Lautstark/voice-button/compact72/exploded.png

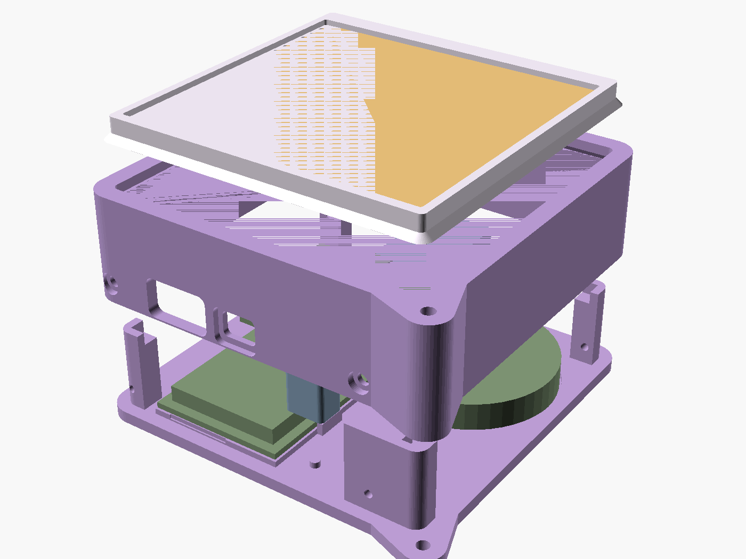
compact72/exploded.png
