Lautstark/voice-button/compact72/inside.png

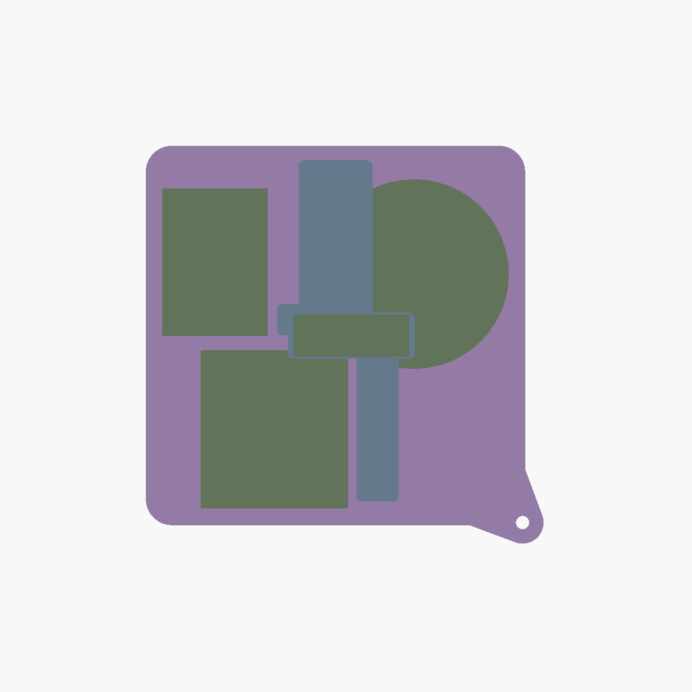
compact72/inside.png
