Lautstark/voice-button/compact72/preview.png

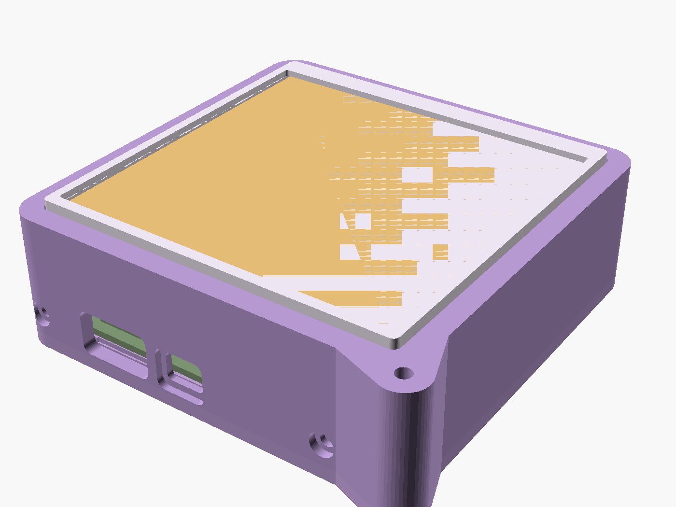
compact72/preview.png
