Lautstark/voice-button/compact72/stl/base.stl

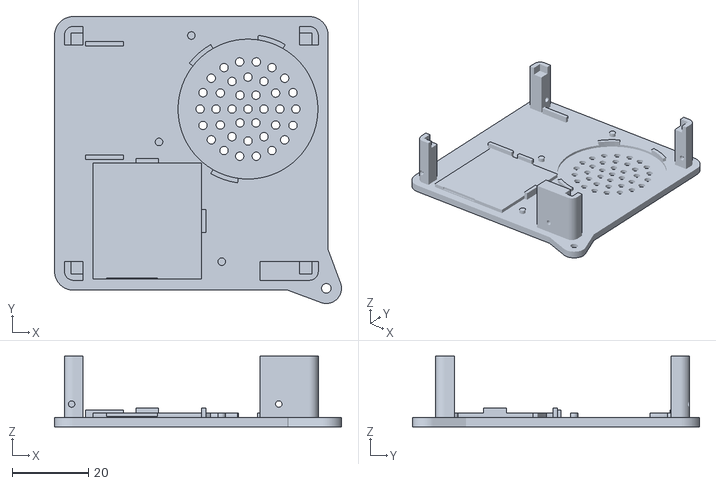
[picture p4: CAD file, 2026-10-31]
compact72/stl/base.stl
75.5 x 75.5 x 18.6
