Lautstark/voice-button/compact72/stl/frame.stl

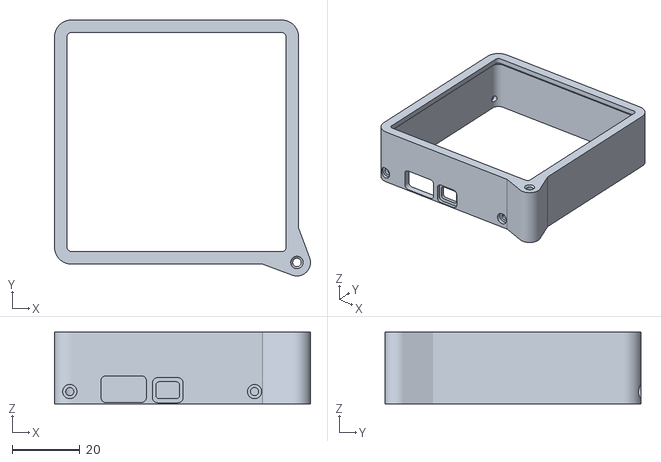
[picture p5: CAD file, 2026-10-31]
compact72/stl/frame.stl
75.5 x 75.5 x 21.1
