Lautstark/voice-button/compact72/stl/bridge.stl

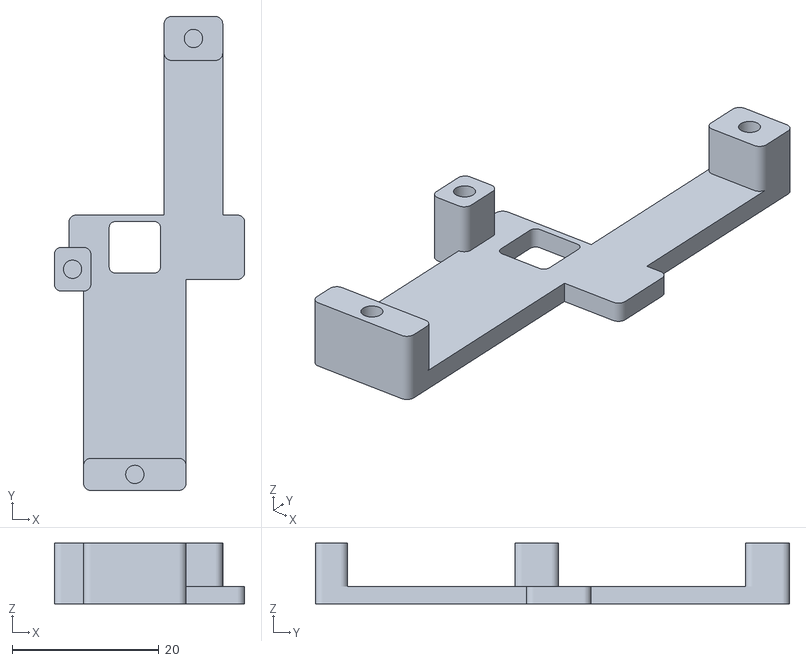
[picture p6: CAD file, 2026-10-30]
compact72/stl/bridge.stl
26.0 x 64.7 x 8.30
