Lautstark/voice-button/compact72/stl/button.stl

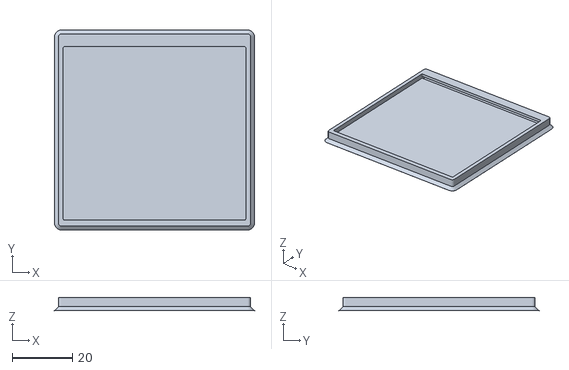
[picture p7: CAD file, 2026-10-30]
compact72/stl/button.stl
66.6 x 66.6 x 4.40
