Lautstark/voice-button/(commit log)

2026-10-26 Parametrischer AAC-Sprachknopf zum Anhängen, erster Entwurf
    OpenSCAD-Projekt um das diymore-16-MB-Soundmodul (B0HC2YW72V):
    Rückschale, schwimmende Frontplatte mit METACOM-Kartenhalter
    (drei Schienen + Nase), Blende und Tasterbrücke, dazu Testteile,
    STL-Exporte, Renderings und Kollisionschecks (check_fit.sh).
    Maße von USB-C, Schalter und Lautsprecher sind als [MEASURE]
    markierte Platzhalter, bis das Modul vermessen ist.
    [assembly.scad, bezel.stl, bridge.stl, config.scad, front_plate.stl, lib.scad, main.scad, parts.scad]
2026-10-27 Karte wird eingeschoben statt gebogen
    Der erste Testdruck zeigte: ein ringsum berandeter Rahmen hat keinen
    flachen Einlass, die Karte muss sich wölben und knickt dabei sichtbar.
    Der Halter bekommt deshalb einen Einschubschlitz in der Westwand. Nord-
    und Südlippe laufen jetzt über die volle Breite und halten die Karte quer
    zur Schieberichtung in jeder Position; eine 0,15-mm-Rastnase sperrt den
    Rückweg, eine Mulde in der Ostlippe drückt sie wieder heraus.
    Der Rahmen wird dadurch 1,5 mm breiter, die mittlere Ostschraube rückt
    nach außen und die Blendenöffnung wird bis unter stop_z ausgeschnitten,
    damit die Säule nicht in den Weg der Platte ragt. Gehäuse außen unverändert.
    check_fi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
    [assembly.scad, bezel.stl, bridge.stl, config.scad, front_plate.stl, main.scad, parts.scad, press_rig.stl]
2026-10-27 Rastnase in die Schlitzwand, Rahmen wieder quadratisch
    Die Nase braucht keinen eigenen Platz im Kanal: im Schlitz der Westwand
    sitzt sie dort, wo ohnehin 1,4 mm Höhe sind. Damit fällt die 1,5 mm
    Extrabreite weg, das Fenster ist wieder 45,4 mm quadratisch, die mittlere
    Ostschraube bleibt an ihrem alten Platz, und die Karte liegt im Kanal
    plan auf statt auf einer Rampe. Nasenhöhe 0,4 mm = zwei Druckschichten;
    0,15 mm hätte der Slicer verschluckt.
    Die Lippenüberdeckung bleibt bei 1,3 mm. Nicht sie begrenzt den Halt,
    sondern das Kanalspiel von 0,4 mm — Rechnung in docs/mechanism.md.
    card_seat_* ziehen nach config.scad um: `use <>` importiert Module, aber
    keine Variablen, deshalb lief de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
    [assembly.scad, bezel.stl, bridge.stl, config.scad, front_plate.stl, main.scad, parts.scad, press_rig.stl]
2026-10-27 Karte wird oben eingehängt statt seitlich eingeschoben
    Der Einschub war nicht ladbar: der Kartenrahmen ist ein bewegliches Teil
    innerhalb der Blendenöffnung, mit 0,3 mm Luft ringsum. Gehäusewand und
    Blendenkragen stehen mit 115 mm³ im Weg jeder seitlichen Zufuhr — egal an
    welcher Kante der Schlitz sitzt. Zugänglich ist nur die Vorderseite.
    Also: tiefe Tasche oben (2,7 mm, davon 1,2 mm im Sitz im Eingriff), 1,0 mm
    Lippe unten, keine Seitenlippen. Oberkante einhängen, 1,5 mm hochdrücken,
    flach ablegen, loslassen — die Schwerkraft setzt die Karte auf die untere
    Lippe und in eine 0,4 mm tiefe Sitzmulde mit 15°-Rampe. Kein Biegen. Der
    Fluchtweg zeigt nach oben, also gegen die Schwerk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
    [assembly.scad, bezel.stl, bridge.stl, config.scad, front_plate.stl, main.scad, parts.scad, press_rig.stl]
2026-10-27 Kartenhalter auf eine blanke Mulde zurückgebaut
    Zwei Mechanismen sind gescheitert: Lippen ringsum knicken die Karte, ein
    Einschubschlitz ist nicht erreichbar. Von vorn braucht es keinen — also
    eine 40,4 x 40,4 x 0,9 mm Mulde im Rahmenblock, Fingerkerbe unten, fertig.
    Die Karte hält mit zwei Punkten doppelseitigem Klebeband.
    Der Rahmen druckt damit ohne einen einzigen Überhang und ohne Brücke; die
    Lippenunterseiten und Schlitzdächer waren die kritischen Stellen.
    check_card_seated hat beim Umbau gleich etwas gefunden: bei 1,5 mm
    Eckenradius der Mulde ragen die spitzen Kartenecken 0,34 mm hinein und die
    Karte liegt nicht plan. Radius jetzt 0,5 mm, mit der Begruendung im Code.
    Co-Autho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
    [assembly.scad, bezel.stl, bridge.stl, config.scad, front_plate.stl, main.scad, parts.scad, press_rig.stl]
2026-10-27 Blende hält die Karte, Fingermulde entfällt
    Die Blendenöffnung verengt sich 0,2 mm über dem Rahmen auf 38 mm und
    übergreift die Karte damit ringsum um 1 mm. Kein Klebeband, kein
    Rastelement, nichts, woran ein Kind picken könnte. Preis: der Wechsel
    kostet die drei Blendenschrauben — Abwägung im ADR.
    Damit kann die Fingermulde weg: mit abgenommener Blende hat man die Platte
    in der Hand und drückt die Karte durch zwei 5-mm-Löcher von hinten heraus.
    Die Vorderseite bleibt ungestört, und es gibt keine Kante zum Ansetzen.
    Beide Löcher liegen über je einem Schaumpad, blicken im montierten Zustand
    also auf nichts als Schaum.
    check_card_captive prüft die Halterung: eine aus der Mulde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
    [assembly.scad, bezel.stl, bridge.stl, config.scad, front_plate.stl, main.scad, parts.scad, press_rig.stl]
2026-10-27 Kartenhalter: Mulde mit zwei Lippen, werkzeugfrei
    Nimmt die Blendenlippe und die Ausdrücklöcher von 1af654b zurück: der
    Wechsel kostet wieder keine Schrauben, und die Drückfläche ist wieder die
    volle Rahmenbreite statt 38 mm.
    Der Halter ist jetzt eine Mulde, die 1 mm höher ist als die Karte, mit je
    einer Lippe oben (1,8) und unten (0,8). Karte oben unter die Lippe
    schieben, loslassen. Kein Klebeband, kein Rastelement, keine Fingermulde,
    keine Sitzmulde — das war alles Beiwerk.
    Lippen an drei Seiten gehen nicht: seitliche Lippen müssten über die volle
    Höhe laufen, dann kann die Karte nur noch in ihrer Ebene nach oben heraus,
    und das sperrt die Blende (Öffnung nur 0,3 mm höher a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
    [assembly.scad, bezel.stl, bridge.stl, config.scad, front_plate.stl, main.scad, parts.scad, press_rig.stl]
2026-10-27 Erst Echtteile drucken, nicht das Testplaettchen
    Frontplatte und Blende haengen an keiner der offenen [MEASURE]-Groessen:
    mit auf Anschlag verstellten Werten fuer Taster, Lautsprecher, Akku und
    Breakout kommen beide mit identischer Bounding Box und identischem Volumen
    heraus. Sie koennen also jetzt schon gedruckt und behalten werden.
    front_plate kostet 9 g gegenueber 8 g fuer test_card -- das Testplaettchen
    spart nichts mehr und beantwortet weniger. Zusammen mit bezel zeigt der
    Druck ausserdem die Kragenpassung, die sonst erst zum Schluss auffaellt.
2026-10-27 Kompletter Satz druckbar, Kartenhalter toleranzfest
    Kartenhalter: lip_top von 1,8 auf 3,0 mm. Das Toleranzfenster fuer die
    Kartenhoehe ist lip_top - lip_bottom - 0,75 breit, war also bisher 0,25 mm
    -- die Karte haette auf +/-0,12 mm genau geschnitten sein muessen. Jetzt
    39,3 bis 40,7 mm, und die Muldenhoehe wird so abgeleitet, dass die
    Nennkarte in der Mitte des Fensters liegt. Der Bereich wird beim Rendern
    ausgegeben. Eine 0,4-mm-Stufe im Boden unter der Lippe faengt deren Durchhang.
    PCB-Layout nach dem Produktfoto: USB-C und ON-OFF liegen auf derselben
    Kante (bei ~11 und ~24,6 mm), drei JST-Bloecke an den anderen Seiten.
    Dafuer Kabelausschnitte nach Westen und Sueden im Platinenfach.
    che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
    [assembly.scad, bezel.stl, bridge.stl, config.scad, front_plate.stl, parts.scad, press_rig.stl, rear_shell.stl]
2026-10-27 Druckliste: Plattenbelegung ergaenzt
    Alle vier Teile belegen 150 x 156 mm von 220 x 220 -- passen also bequem
    zusammen auf eine Platte. Mit den drei praktischen Punkten dazu
    (Leerfahrten, Brim fuer die Bruecke, nur die Frontplatte ist ggf. zu
    wiederholen).
2026-10-27 Review: Mittenanschlag, Akkusockel, Schaum, Kartenbreite
    Drei echte Konstruktionsfehler, gefunden von zwei unabhaengigen
    Nachpruefungen plus eigenem Druckbarkeits-Audit:
    1. ANSCHLAG. Der 12x12-Taktiltaster geht nach 0,55 mm auf Block, die
    Umfangsrippen kamen erst bei 1,8 mm. Die Platte waere bei jedem
    mittigen Druck 1,25 mm ueber den blockierten Taster hinausgefahren --
    volle Handkraft ueber Tasterkappe, Breakout und 1,6-mm-Bruecke. Die
    Waende der Breakout-Tasche sind jetzt auf 12,7 mm hochgezogen und
    fangen die Platte neben dem Taster ab. Ueberhub 1,25 -> 0,15 mm,
    Kragenfuehrung am Hubende 0,8 -> 1,9 mm. Neuer Check check_centre_stop.
    2. AKKUSCHALE. Sie hing als 31 x 21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
    [bezel.stl, bridge.stl, config.scad, front_plate.stl, main.scad, parts.scad, press_rig.stl, rear_shell.stl]
2026-10-27 Schaumpads: Haushaltsmaterial statt Kaufteil, Sitze auf der Bruecke
    Die Pads muessen nur eine 9-g-Platte zurueckholen, also ist weich besser
    als fest -- und die weiche Seite eines Spuelschwamms (offenzelliger PU)
    trifft die ~1 N besser als gekauftes Neoprenband. Dokumentiert mit den
    Alternativen (Ohrpolster, Verpackungsschaum, Isomatte) und den drei
    Materialien, die nicht gehen: Moosgummi (~20 N), Memory-Schaum (federt zu
    langsam, Taste fuehlt sich tot an), Filz (federt gar nicht).
    foam_t auf 6,0 mm, dazu 0,5 mm hohe Sitze auf der Bruecke: die heben
    handelsuebliche 6-mm-Ware ins Vorspannungsfenster UND markieren sichtbar,
    wo die Pads hingehoeren -- naemlich zwischen die Versteifungsrippen,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
    [bezel.stl, bridge.stl, config.scad, front_plate.stl, parts.scad, press_rig.stl, rear_shell.stl, test_card.stl]
2026-10-27 Review-Prompt fuers naechste unabhaengige Review abgelegt
    Formuliert, ohne zu den bisherigen Schluessen hinzufuehren: nennt die
    angewandten Methoden, aber nicht deren Ergebnisse, und weist ausdruecklich
    an, weder Doku noch Code-Kommentare noch die vorhandenen Checks zu
    glauben, sondern aus den Parametern neu abzuleiten.
2026-10-27 Review-Prompt wieder aus dem Repo nehmen
    Gehoert nicht zum Bauprojekt -- er ist Arbeitsmaterial fuer einen
    einmaligen Reviewdurchlauf, nicht Teil der Dokumentation des Geraets.
2026-10-27 Externes Review: sieben Konstruktionsfehler und zwei blinde Checks
    Ein unabhaengiger Reviewer fand am Stand df3c1f2 Fehler, die alle zwoelf
    damaligen Checks passiert hatten. Drei davon habe ich selbst nachgemessen,
    bevor ich sie akzeptiert habe; alle drei stimmten.
    ZUERST DAS PRUEFGERUEST, weil ohne das jede Reparatur ungedeckt waere:
    * OpenSCAD 2021.01 gibt fuer ein LEERES Ergebnis denselben Exitcode 1 wie
    fuer einen echten Fehler. Abgestuerzte Renderings wurden als PASS
    gezaehlt. Jetzt zuerst Fehlermeldung pruefen, dann leer; ein unbekannter
    Teilname loest ein assert aus statt lautlos nichts zu rendern.
    * `use <datei.scad>` importiert Module, aber keine Variablen. Eine so
    geholte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
    [assembly.scad, bezel.stl, bridge.stl, config.scad, front_plate.stl, lib.scad, main.scad, parts.scad]
2026-10-27 Pruefgeruest: Exitcode wird jetzt tatsaechlich ausgewertet
    RC war gespeichert, aber nie geprueft. Ein Lauf mit Exitcode != 0, der
    weder "ERROR" in die Ausgabe schrieb noch sich als leer meldete, kam als
    PASS durch. Der Leerfall bleibt der einzige erlaubte Nicht-Null-Fall --
    openscad 2021.01 nutzt dafuer denselben Code wie fuer echte Fehler.
    Gemeldet im zweiten externen Review.
2026-10-27 Blende entfaellt: Platte schwimmt auf drei Schrauben
    Nach dem zweiten externen Review und der Frage, ob der Mechanismus nicht
    einfacher geht. Durchbiegen der Platte scheidet aus (439 N bei 2 mm, 55 N
    bei 1 mm fuer 0,55 mm Weg; die Spec verbietet ausserdem wiederholte
    PLA-Verformung). Als starr bewegte Platte funktioniert es:
    Drei Dome der Schale ragen durch Aussparungen der Platte bis auf deren
    Vorderseite. Die Schraube wird AUF den Dom gezogen und klemmt die Platte
    deshalb nicht; eine Unterlegscheibe haelt den Rand der Aussparung. Die
    Waende enden buendig mit dem Kartenrahmen, Scheiben und Koepfe liegen
    damit 1,2 mm versenkt in der Wanne.
    Entfallen: die Blende als Druckteil, ihr Fuehrungs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
    [assembly.scad, bezel.stl, bridge.stl, config.scad, front_plate.stl, lib.scad, main.scad, parts.scad]
2026-10-28 Architektur B: Frontgehaeuse, eingefangene Taste, Rueckdeckel
    Loest Architektur A ab. Der letzte Review hatte gezeigt, dass die auf
    drei Schrauben schwimmende Platte nicht montierbar war: eine
    selbstschneidende M2-Saeule in PLA braucht Ø4,4, ein M2-Kopf hat Ø3,8 —
    der Kopf kann die Durchgangsoeffnung nie ueberdecken, und fuer die
    Scheibe war zwischen Innenwand und Kartenrahmen kein Platz. Das war kein
    Massfehler, sondern ein Architekturfehler.
    Jetzt drei Teile, vier Schrauben, keine Schraube durch ein bewegliches
    Teil, keine lose Scheibe. Die Taste wird von hinten eingelegt und von
    einem umlaufenden 45-Grad-Konus gehalten.
    Zwei Entscheidungen tragen den Entwurf:
    Anschlagring und Halte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
    [assembly.scad, bridge.stl, button.stl, config.scad, front_housing.stl, front_plate.stl, lib.scad, main.scad]
2026-10-28 Gemessene Hardware: Kavitaet 84, Lautsprecher in den Deckel eingesenkt
    Die Bauteile sind eingetroffen und vermessen. Das wirft drei Annahmen um
    und laesst das Geraet von 76 auf 93 mm wachsen — dafuer wird es von 22,4
    auf 21,3 mm flacher.
    Gemessen statt angenommen:
    Lautsprecher Oe 36 x 6 statt Oe 23 x 4, Metallfassung
    Hauptplatine 28 x 30 statt 29 x 27
    Akku 5 x 20 x 28 statt 4,3 x 20 x 30
    Tasterplatine 8 x 22 statt 16 x 22
    Tasterstempel 4,0 statt 4,3 ueber der Platine
    Ports USB-C bei 10, Schieber bei 23 der 28-mm-Kante
    Kabel Lautsprecher und Akku je 20 mm
    Widerlegte Annahmen:
    - Ein 12x12-Taster passt nicht auf eine 8 mm breite Platine. Es ist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
    [assembly.scad, button.stl, config.scad, front_housing.stl, main.scad, parts.scad, rear_lid.stl]
2026-10-29 Review von 5d55b20: fuenf Befunde behoben, Ladestecker erreicht die Buchse
    Ein externer Review nannte sechs Punkte. Fuenf waren echte Befunde, der
    sechste bestaetigte eine schon dokumentierte Grenze. Jeder wurde am Code
    nachgeprueft statt uebernommen; Abschnitt 4d im Handoff fuehrt sie mit
    "nachgeprueft wie" und "behoben durch" auf.
    1 Senkung: Rand war 0,15 mm, und der assert pruefte nur das Kernloch.
    Der Rand ist (corner_r - corner_ri - screw_cb_d)/2 und damit vom
    Aussenradius unabhaengig. Senkung entfaellt, Linsenkopf liegt auf
    der Deckelflaeche, Schraube wird M2x10 (6,0 statt 4,0 mm Gewinde
    in der Wand), Moebelpuffer 3 mm und nicht mehr in die Ecken.
    2 Padtasche: in D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
    [assembly.scad, button.stl, config.scad, front_housing.stl, main.scad, parts.scad, rear_lid.stl]
2026-10-29 Steckerzugang vollstaendig gesteckt modelliert, Pad-Assert, Lautsprecher-Mock
    Drei angeforderte Punkte plus die Folgefehler, die dabei herauskamen.
    1 USB-Zugang. Das Steckermodell endete mit der Metallspitze GENAU an
    der Buchsenoeffnung — das ist die ungesteckte Lage, Eingriff null.
    Jetzt sind vier Groessen getrennt: usb_shell_l (Metall), usb_proud
    (Buchsenstirn vor der Platinenkante), usb_gap_seated (Luft zwischen
    Griff und Buchse im gesteckten Zustand) und daraus usb_grip_y und
    usb_channel_d. Ergebnis: der Griff muss bis an die Buchsenstirn, also
    9,7 mm hinter die Aussenflaeche — hinter Wand UND Anschlagring. Eine
    3,2-mm-Tasche konnte das nie leisten. Der Durchbruch hat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
    [assembly.scad, button.stl, config.scad, front_housing.stl, main.scad, parts.scad, rear_lid.stl]
2026-10-29 Karte zurueck auf 40 mm, Pruefluecken geschlossen, Anschlagnasen
    Karte 64 -> 40: die beiden Haltelippen sind in Drucklage Bruecken ueber
    die ganze Muldenbreite. Gemessen: Schicht bei Druck-z 3,30 enthaelt
    49,29 mm3 (= genau die beiden Lippen), eine Schicht tiefer 0,044 — sie
    haengen auf voller Laenge in der Luft. Bei 64,8 mm Spannweite ist die
    untere mit 0,8 mm Breite nicht mehr zuverlaessig druckbar; bei 40,8 ist
    es die Geometrie, die in Architektur A am Druck erprobt war.
    Vier Pruefluecken geschlossen, die aus drei unabhaengigen Reviews kamen:
    - check_stop_face_height: ein um 1,3 mm zu hoher Anschlagring kuerzt
    den Tastenweg auf 0,7 mm und das Geraet loest nie aus. Keine
    Pruef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
    [assembly.scad, button.stl, config.scad, front_housing.stl, main.scad, parts.scad, rear_lid.stl]
2026-10-29 Klotz und Anschlagring raus, vier Eckpfosten: 93 -> 85 mm
    Zwei Streichungen, die zusammen acht Millimeter Kantenmass machen.
    Die Tasterplatine stand bisher auf einem gedruckten Sockel auf dem
    Deckelboden. Der brauchte 8 mm Boden in der Reihe Platine-Sockel-
    Lautsprecher und zwang den Lautsprecher zusaetzlich auf 18,4 mm
    Abstand von seinen Ecken. Sie klebt jetzt auf dem Ruecken des
    Lautsprechers, ueber dem Magneten — dem einzigen steifen, flachen
    Teil im Gehaeuse, das keinen eigenen Fussabdruck braucht. Dazwischen
    ein gedruckter Zwischenleger von 1,6 mm als viertes Druckteil: er gibt
    den Loetbeinen des Tasters ein Fenster und macht die Auflage steif.
    Der umlaufende Anschlagring ist durch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
    [assembly.scad, button.stl, config.scad, front_housing.stl, main.scad, parts.scad, rear_lid.stl, switch_shim.stl]
2026-10-30 Plattenbelegung: vier Teile passen in zwei Reihen auf eine Platte
    Die alte Zeile rechnete nur eine Reihe und schloss daraus, dass es
    nicht geht. Bei 85 statt 93 mm passen sie in zwei Reihen auf 196 x 194
    — eng, aber moeglich. Empfehlung bleibt zwei Platten, jetzt aber mit
    der richtigen Begruendung.
2026-10-30 Add compact 72 mm enclosure with 60 mm symbol card
    [base.stl, bridge.stl, button.stl, compact72.scad, frame.stl]
2026-10-30 Integrate rounded cord eye into base corner and review clearances
    [base.stl, compact72.scad, frame.stl]
2026-10-30 Schnurlobe mit dem Koerper verschmolzen statt angesetzter Lasche
    Die flache Ecklasche war handwerklich in Ordnung, aber sie beantwortete
    eine andere Frage: Vorgabe war, dass das Grundquadrat 72 x 72 bleibt und
    moeglichst wenig darueber hinausragt. 8 mm je Seite an einer Ecke sind
    das Gegenteil. Dazu sitzt eine angesetzte Lasche an einer Einschnuerung,
    und die ist bei einem Geraet am Schluesselbund genau die Stelle, die
    bricht.
    Jetzt waechst die Ecke selbst in die Lobe: die Kante verlaesst die
    Gerade 9 mm vor der Ecke und laeuft tangential hinein. Die Form entsteht
    als hull() zweier Kreise und ist damit DURCHGEHEND KONVEX — dort kann
    keine Kehle entstehen, auch wenn spaeter jemand an den Z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
    [base.stl, bridge.stl, button.stl, compact72.scad, frame.stl]
2026-10-30 Top-README auf die verschmolzene Lobe korrigiert
    Dort stand noch die alte Lasche mit 4-mm-Loch und 8 mm Ueberstand.
2026-10-30 Verwaiste Pruefprotokolle entfernt
    check_eye_hole und check_cord_bore gibt es nicht mehr; ihre Protokolle
    lagen als Leichen im Verzeichnis und haetten beim naechsten Review so
    ausgesehen, als waeren sie noch Teil des Laufs.
2026-10-30 Bilder der abgeloesten Architektur A entfernt
    renders/ zeigte part_bezel, part_front_plate, part_rear_shell und
    part_test_card — Teile, die es seit zwei Umbauten nicht mehr gibt. Kein
    Modul, kein Skript und kein Dokument verweist darauf. Fuer einen Review
    waeren das Bilder von einem Geraet, das nicht existiert.
    Die aktuellen Ansichten liegen in render/ (Einzahl) und in compact72/.
2026-10-30 Einstieg fuer den Review: welcher der zwei Entwuerfe gilt
    Im Repo liegen zwei Entwuerfe nebeneinander, und bisher stand nur ein
    Halbsatz dazu. Ein Reviewer haette nicht erkennen koennen, welcher der
    zu pruefende ist und welcher der abgeloeste Rueckfall, und haette
    moeglicherweise den falschen geprueft.
    Jetzt eine Tabelle mit beiden, den Befehlen zum Reproduzieren der
    Pruefungen und dem Hinweis, dass sie keinen Code teilen.
2026-10-30 Abgeloesten 85er Entwurf aus main entfernt
    Im Repo lagen zwei Entwuerfe nebeneinander, die keinen Code teilten.
    Fuer einen Review ist das Ballast: man muss erst herausfinden, welcher
    gilt. Der 85er bleibt bis abfec20 in der Historie erhalten.
    Entfernt: scad/, stl/, docs/, render/, REVIEW_HANDOFF.md.
    README neu geschrieben, beschreibt jetzt nur noch den aktuellen Stand.
    [assembly.scad, button.stl, config.scad, front_housing.stl, lib.scad, main.scad, parts.scad, rear_lid.stl]
2026-10-30 Pruefung laesst das Arbeitsverzeichnis sauber
    Zwei Dinge machten jeden Prueflauf zu einer Aenderung im Repo:
    Die Protokolle enthielten die Renderzeit, die sich bei jedem Lauf
    aendert. Nach jeder Pruefung waren 33 Dateien veraendert, und man
    konnte nicht mehr sehen, ob sich wirklich etwas an der Geometrie
    getan hat. Die Zeile wird jetzt herausgefiltert.
    Der Validator exportierte die Druckteile mit dem Vorgabe- und
    ueberschrieb damit die committeten STL durch groebere. Nach einem
    Prueflauf lag etwas anderes im Repo als das, was gedruckt werden
    sollte. Teile werden jetzt mit festem =72 exportiert.
    Damit ist jede Abweichung nach einem Lauf eine echte
    Geometrieaenderung und kein Rauschen.
    Co-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
    [base.stl, bridge.stl, button.stl, frame.stl]
2026-10-30 STL-Export byte-stabil machen
    OpenSCAD gibt dieselbe Geometrie bei jedem Lauf in anderer
    Facettenreihenfolge aus. Dadurch waren nach jeder Pruefung vier STL
    geaendert, obwohl sich nichts geaendert hatte — und damit war
    git status als Signal wertlos.
    Die Pruefung sortiert die Facetten jetzt in eine feste Reihenfolge.
    Nur die Reihenfolge, kein Zahlenwert. Nachgewiesen: Dreiecksmenge und
    Volumen bleiben identisch (14768,913108 mm3 vor und nach).
    [base.stl, bridge.stl, button.stl, frame.stl]
2026-10-31 Fase am Schnurloch, statt Nacharbeit mit dem Messer
    In der Druckanleitung stand, man solle die Lochkanten mit dem Messer
    brechen. Eine Nacharbeit, die man vergessen kann, ist keine Loesung —
    und eine scharfe Druckkante ist genau das, woran eine Schnur saegt.
    Beide Enden der Bohrung haben jetzt 0,6 mm Fase, und beide sind ohne
    Stuetzen druckbar: unten, auf der Rueckseite des Unterteils, verengt
    sich das Loch nach oben, das Material waechst mit 45 Grad nach innen
    und traegt sich selbst. Oben, auf der Stirnflaeche des Rahmens, oeffnet
    es sich nach oben — gar kein Ueberhang.
    Nicht nur behauptet, am exportierten STL gemessen: Lochradius an beiden
    Oberflaechen 1,840 mm, 0,6 mm tiefer exakt 1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
    [base.stl, compact72.scad, frame.stl]
